HMS-RIC/Datta-Open-Field-Arena/6-Cam PCB v2.0 BOM.xlsx

BOM: 6-Cam Arena PCB
Ref | Name | Make | Model | DigiKey Part | Qty | Notes
U1 | Teensy 4.1 Pins |  |  |  | 1 | Need two 1x24 sockets
U2–9 | FemtoPuck with header pins |  |  |  | 8 | Need sockets on board
J1 | 3.5mm audio jack | CUI | SJ1-3525N | CP1-3525N-ND | 1
J2–7 | 1x5 Screw Term 3.5mm pitch |  |  |  | 6
J8 | High current barrel jack | CUI | PJ-063AH | CP-063AH-ND | 1
J9 | 1x2 Screw Term, 5mm pitch |  |  |  | 1 | We have these in the shop
J10–19 | "Small" barrel jack | CUI | PJ-035D | CP-035D-ND | 10
J20–27 | Standard barrel jack | CUI | PJ-202AH | CP-202AH-ND | 8 | Get at least 10x more, as backup for "Small" power jacks
J28–29 | 1x24 "Debug" headers |  |  |  | 2
J30-35 | Bassler connectors | TE | 640454-5 | A19432-ND | 6
 | Connectors for Bassler cable |  | 3-640442-5 | A30989-ND |  | For 26 gauge wire (Blue)
 |  |  | 3-640441-5 | A30981-ND |  | For 24 gauge wire (White)
 |  |  | 3-640440-5 | A30981-ND |  | For 22 Gauge wire (Red)
