HMS-RIC/Datta-Open-Field-Arena/PDFs/v2.0/Datta-OpenField-PCB__Assembly.pdf

J18 Basler 8 | J27 2 | LED | J39
J11 | FemtoBuck | U6

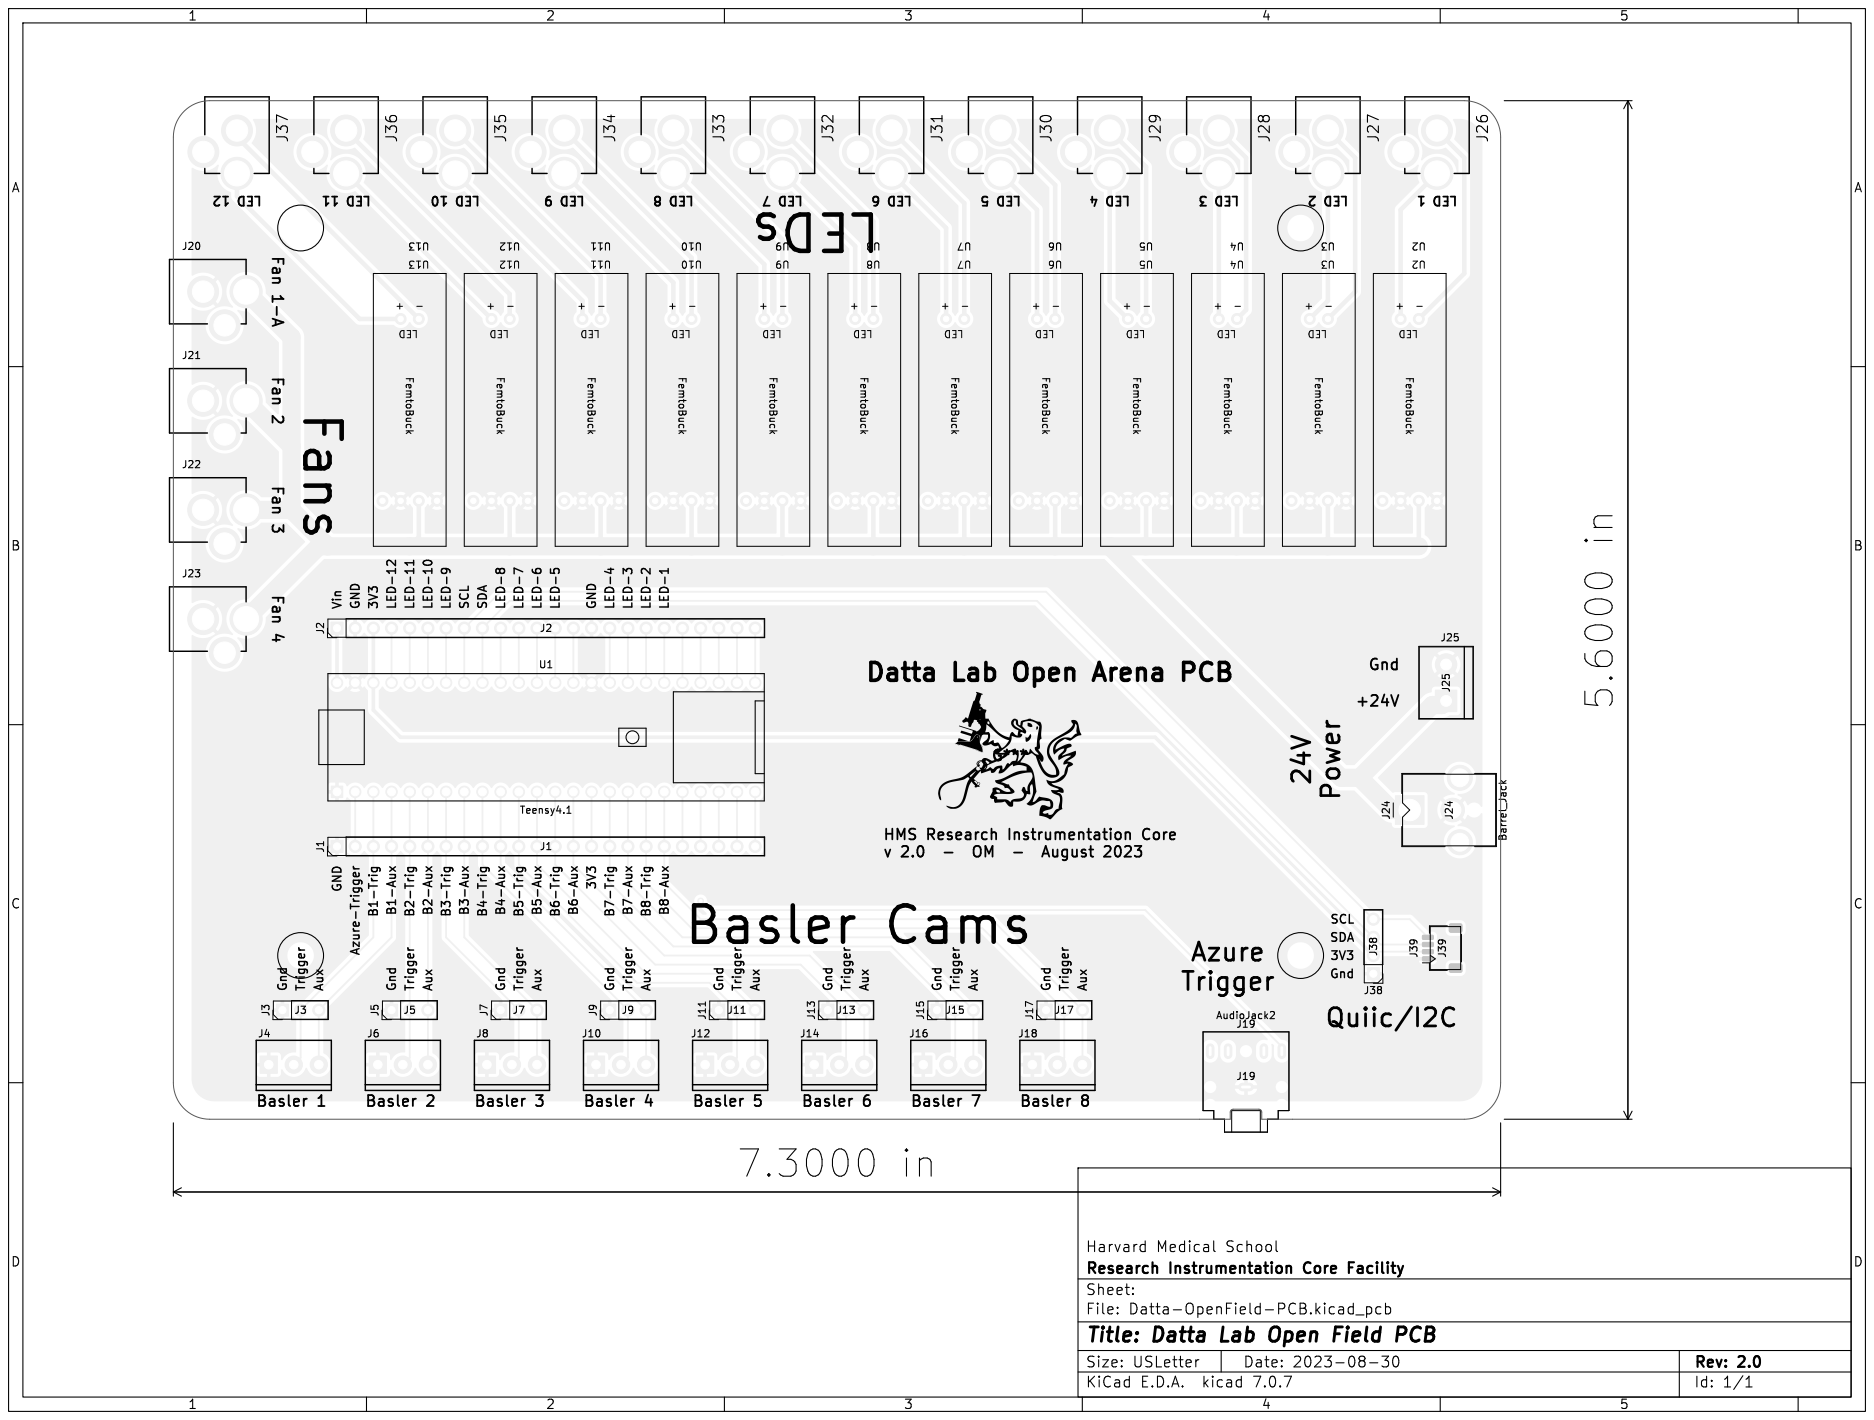
[picture p1: page 1]

Gnd SCL LED-1 Trigger LED-7 Gnd 24V Power B1-Aux LED-3 Gnd B4-Trig B8-Aux

Id: 1/1 Title: Datta Lab Open Field PCB
