HMS-RIC/Datta-Open-Field-Arena/PDFs/v2.0/Datta-OpenField-PCB-v2.0-Schematic.pdf

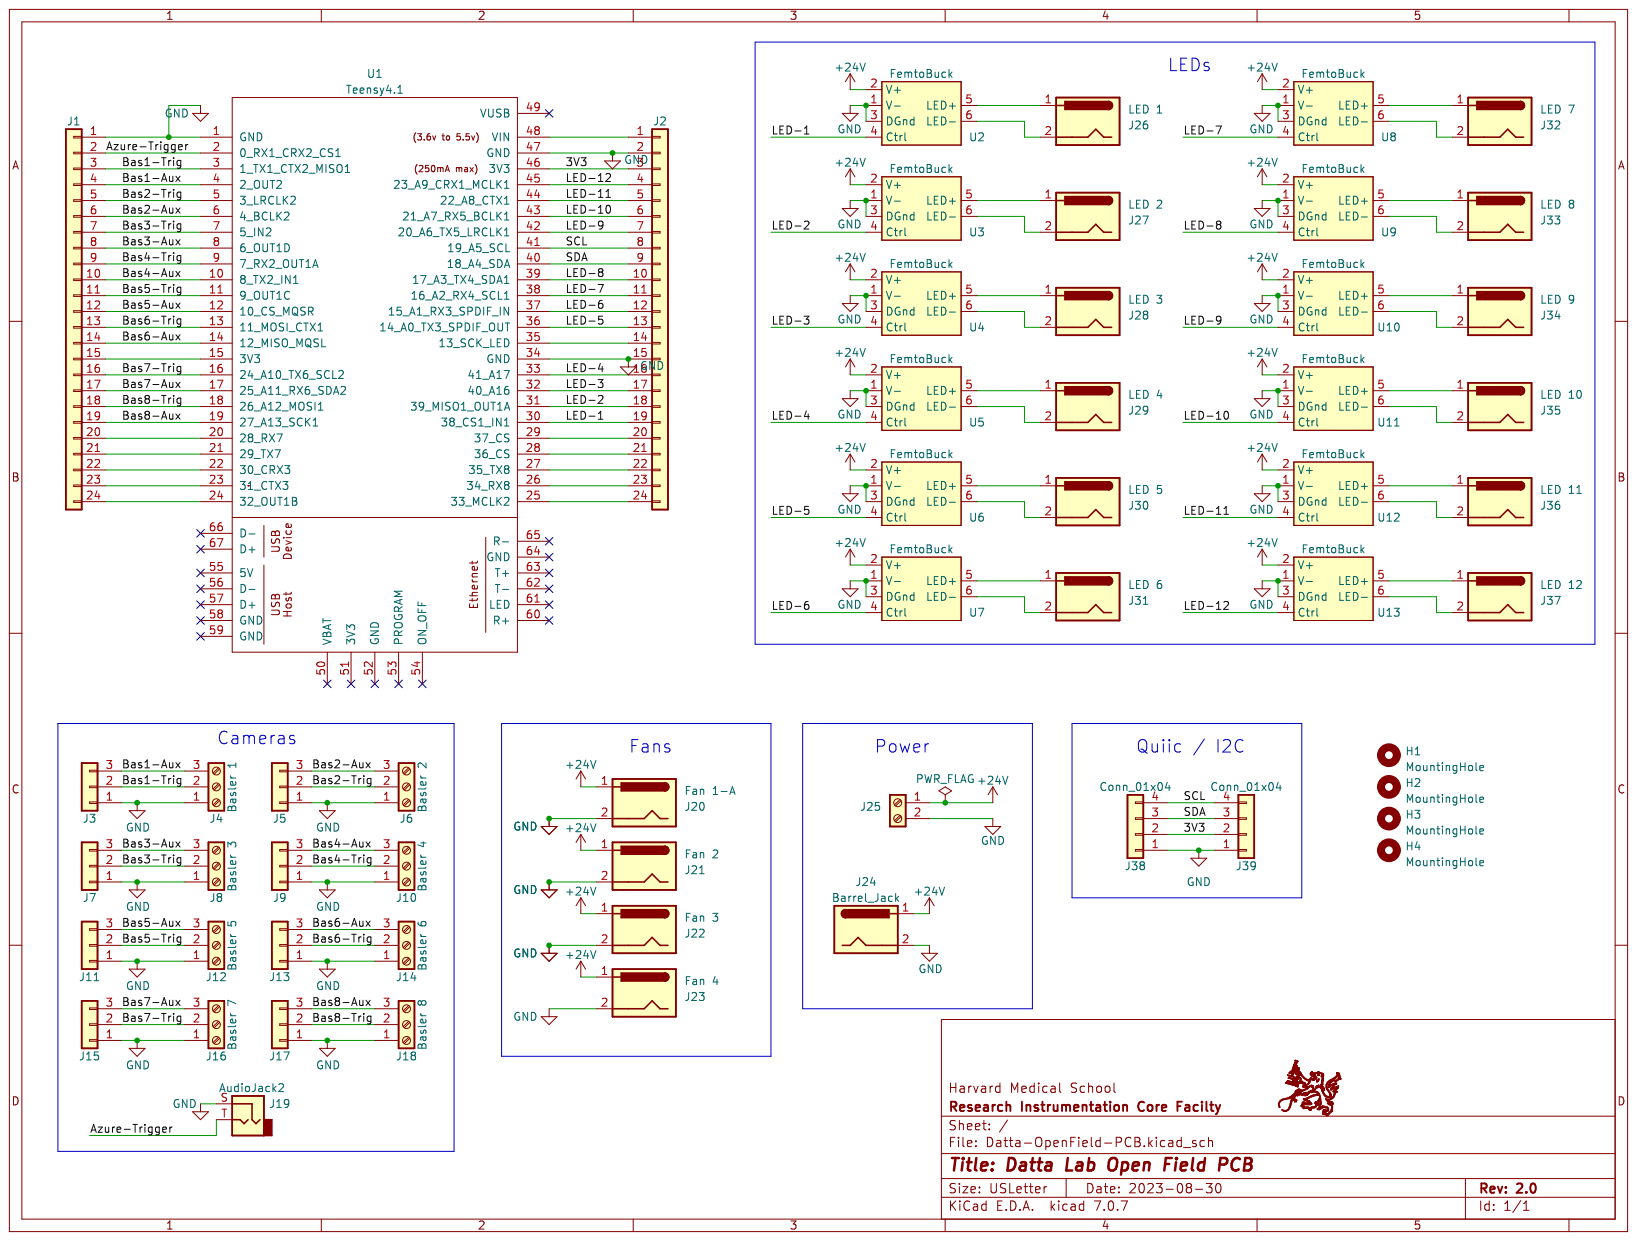
[picture p2: page 1]
