HMS-RIC/Datta-Open-Field-Arena/PDFs/v1.0/6-Cam-v1.0-Schematic.pdf

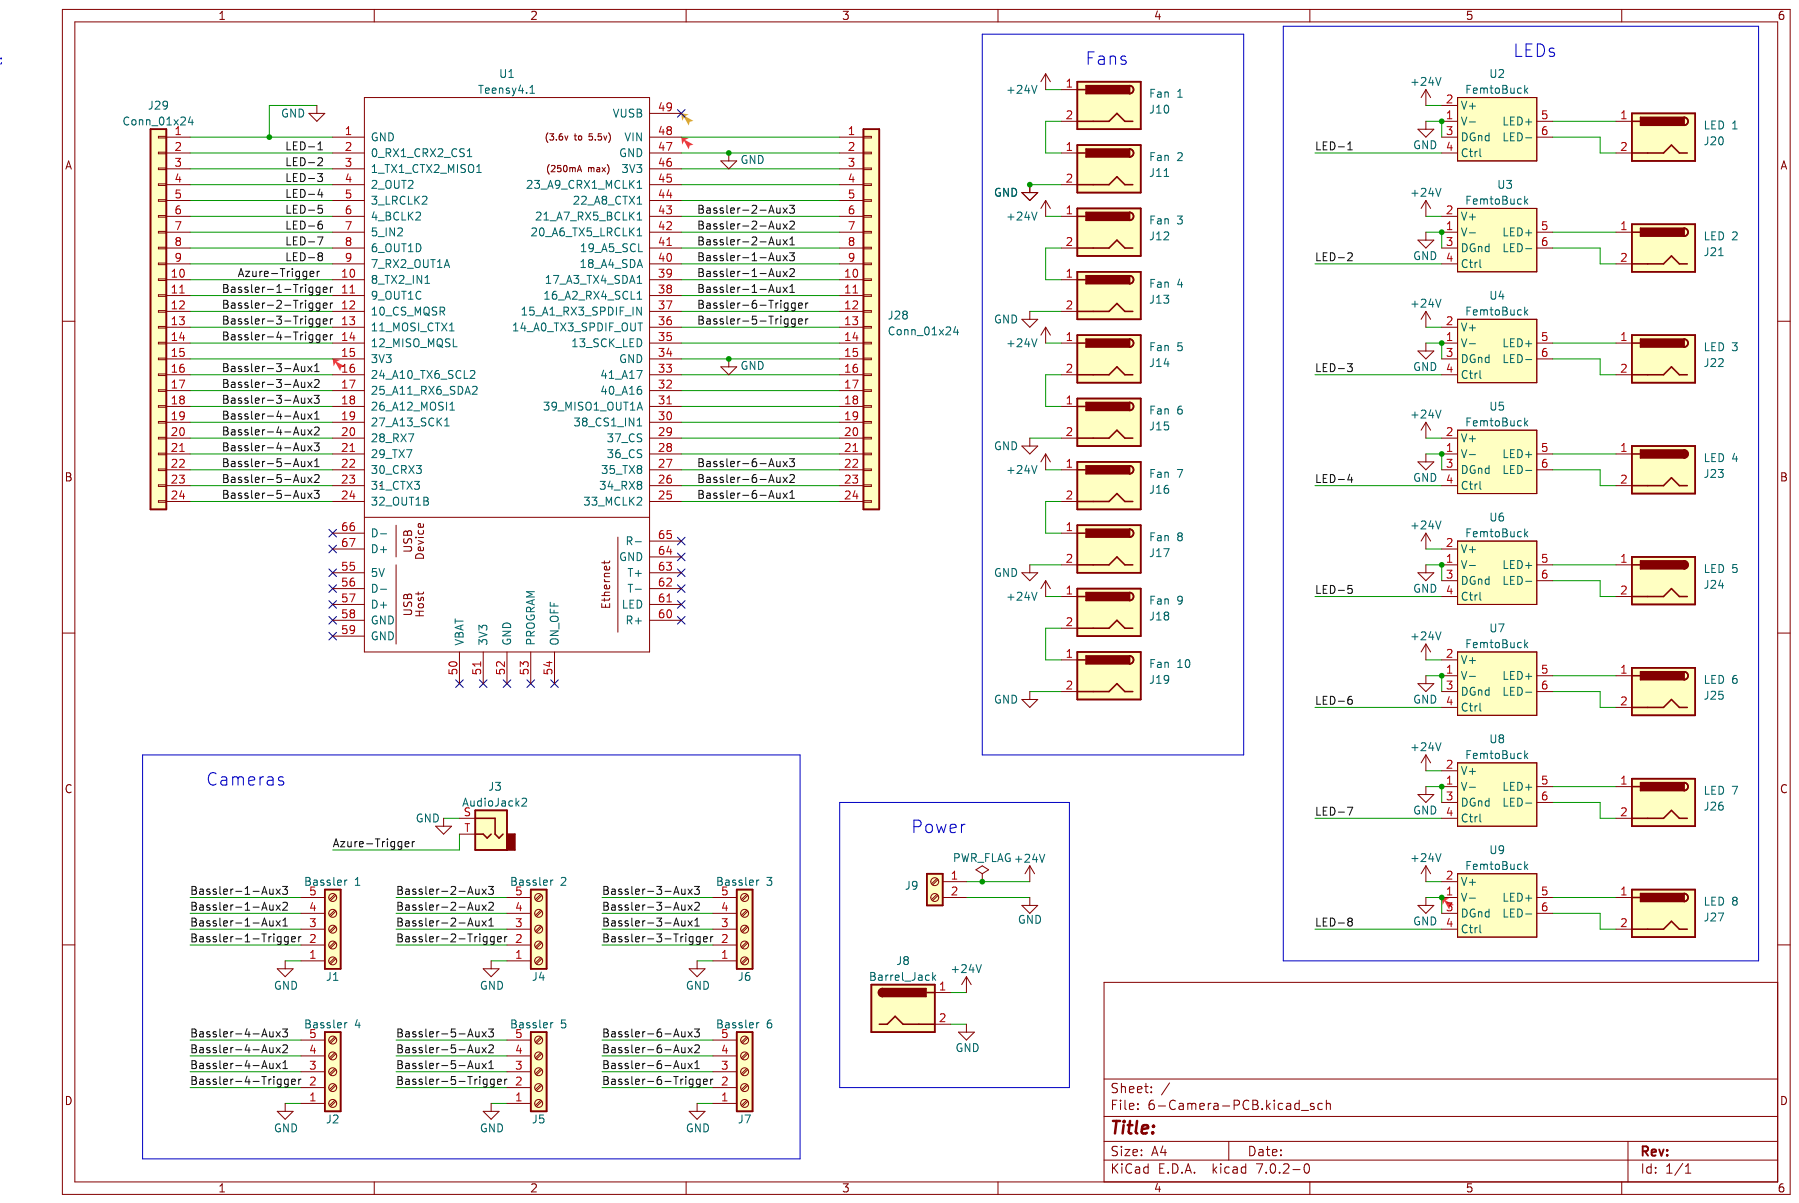
[picture p3: page 1]
