HMS-RIC/Datta-Open-Field-Arena/PDFs/v1.0/6-Cam-v1.0-BoardLayout.pdf

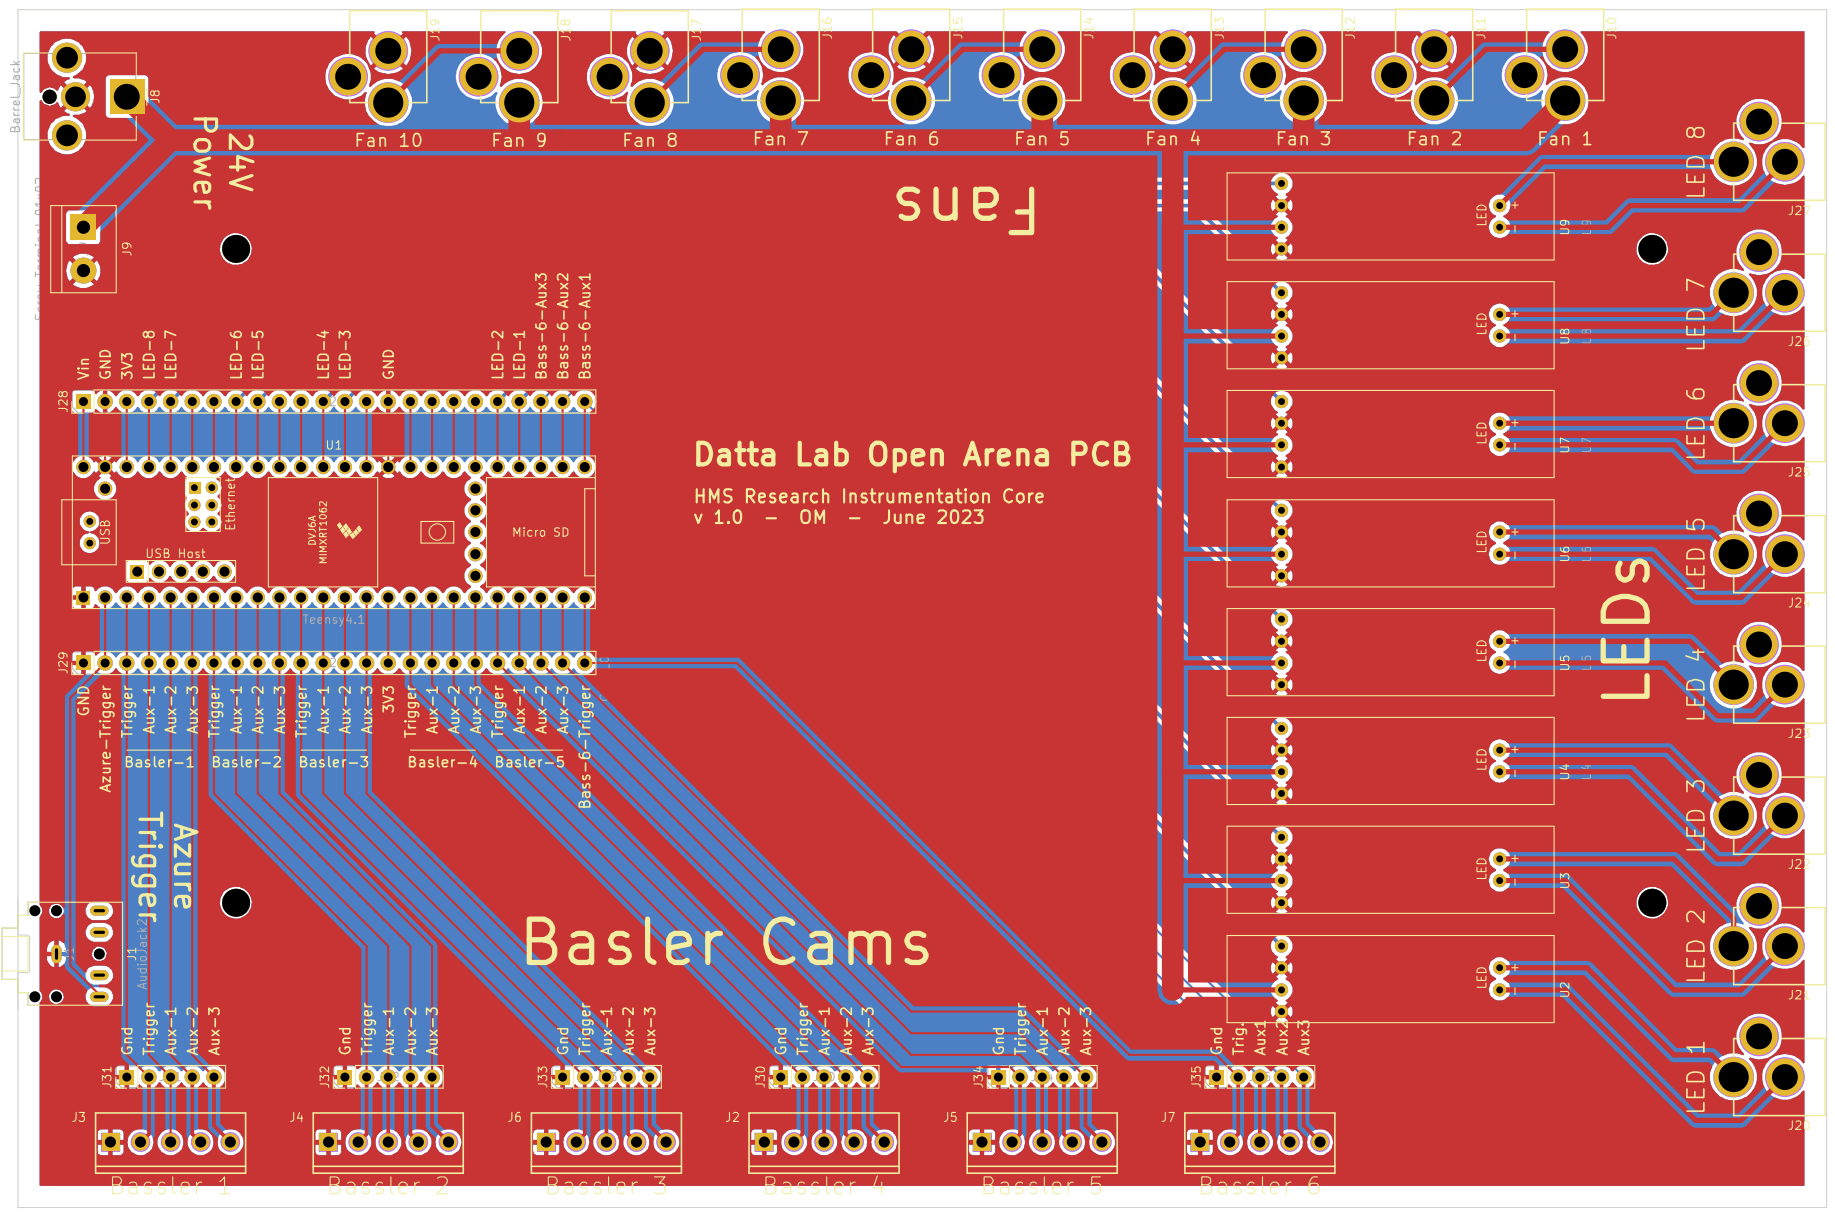
[picture p4: page 1]
