HMS-RIC/Datta-Open-Field-Arena/(commit log)

2023-08-11 Initial commit - v1.0
    [6-Cam PCB v1.0 BOM.xlsx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]
2023-08-11 Change KiCad project name
    [Datta-OpenField-PCB.kicad_pcb, Datta-OpenField-PCB.kicad_sch]
2023-08-11 Add RIC logo
    [Datta-OpenField-PCB.kicad_pcb, Datta-OpenField-PCB.kicad_sch]
2023-08-11 Change to 12V power
    [Datta-OpenField-PCB.kicad_sch]
2023-08-11 Revert to 24V; Upgrade to v2 functionality
    - 12 LEDs, each with 2 FemtoBucks
    - 8 Baslers, 1 trigger and 1 aux pin per camera
    [Datta-OpenField-PCB.kicad_sch, FemtoBucks.kicad_sch]
2023-08-11 Add Quiic/I2C
    [Datta-OpenField-PCB.kicad_sch]
2023-08-16 Fix Quiic pins
    [Datta-OpenField-PCB.kicad_sch]
2023-08-16 Reduce fan count to 4
    [Datta-OpenField-PCB.kicad_sch]
2023-08-16 Rearrange board layout with all v2 changes
    [Datta-OpenField-PCB.kicad_pcb, Datta-OpenField-PCB.kicad_sch, FemtoBucks.kicad_sch]
2023-08-17 Fix schematic to link nets across sheets
    [Datta-OpenField-PCB.kicad_pcb, Datta-OpenField-PCB.kicad_sch, FemtoBucks.kicad_sch]
2023-08-17 Reduce buck count to 12 - one per LED
    [Datta-OpenField-PCB.kicad_pcb, Datta-OpenField-PCB.kicad_sch, FemtoBucks.kicad_sch]
2023-08-17 Minor PCB changes
    [Datta-OpenField-PCB.kicad_pcb]
2023-08-23 Route PCB traces
    [Datta-OpenField-PCB.kicad_pcb]
2023-08-23 Add PDF of v2 schematic
2023-08-23 Add Teensy footprint to local library; Minor changes
    [Datta-OpenField-PCB.kicad_pcb, Datta-OpenField-PCB.kicad_sch]
2023-08-23 Minor changes
    [Datta-OpenField-PCB.kicad_pcb, Datta-OpenField-PCB.kicad_sch]
2023-08-30 Make small adjustments to PCB layout
    [Datta-OpenField-PCB.kicad_pcb, Datta-OpenField-PCB.kicad_sch]
2023-08-30 Make fans 24V, no longer in serial pairs
    [Datta-OpenField-PCB.kicad_pcb, Datta-OpenField-PCB.kicad_sch]
2023-08-30 Change edge cut line thickness
    [Datta-OpenField-PCB.kicad_pcb]
2023-08-30 Generated Gerbers and PDFs for v2.0
    [Datta-OpenField-PCB-B_Cu.gbr, Datta-OpenField-PCB-B_Mask.gbr, Datta-OpenField-PCB-B_Paste.gbr, Datta-OpenField-PCB-B_Silkscreen.gbr, Datta-OpenField-PCB-Edge_Cuts.gbr, Datta-OpenField-PCB-F_Cu.gbr, Datta-OpenField-PCB-F_Mask.gbr, Datta-OpenField-PCB-F_Paste.gbr]
2023-09-01 Update BOM to v2.0
    [6-Cam PCB v2.0 BOM.xlsx]
